devinatkin/tt07-dual-oscillator/(commit log)

2024-04-30 lab 1.2 - inverter schematic
    [top.sch]
2024-05-01 lab 2.2 completed
    [inverter.sch, inverter_tb.sch, untitled.sch]
2024-05-01 Lab 3.2 Start
    [top.sch]
2024-05-02 lab 3.2 complete
    [oscillator_20MHZ.sch, oscillator_21MHZ.sch, top.sch, top_tb.sch, untitled.sch]
2024-05-09 Setting Oscillators to roughly 20Mhz and 21Mhz
    [inverter.sch, oscillator_20MHZ.sch, oscillator_20MHZ_TB.sch, oscillator_21MHZ.sch, oscillator_21MHZ_TB.sch, top.sch, top_tb.sch, untitled.sch]
2024-05-23 Op Amp Schematic Completed
    [opamp_1.sch, opamp_1_tb.sch]
2024-05-23 Op Amp Layout V1 Complete
    [active-resistor.sch, activeload.sch, current_source.sch, current_source_tb.sch, indiff.sch, opamp_1.sch, opamp_1_tb.sch, opamp_1_tb_2.sch]
2024-05-24 Top Cell (passing LVS)
    [current_source.sch]
2024-05-28 Increase Post Layout Frequency
    [filter_oscillator_20mhz.sch, oscillator_20MHZ.sch, oscillator_20MHZ_TB.sch, oscillator_21MHZ.sch, oscillator_21MHZ_TB.sch, ps_oscillator_20mhz.sch, top_tb.sch, untitled-1.sch]
2024-05-29 Initial Filter Based Design
    [analog_buffer.sch, filter22M.sch, filter22M_TB.sch, single_transistor_filter_tb.sch, top.sch, top_tb.sch, top_tb_postL.sch, untitled-2.sch]
2024-05-31 Complete Full Layout (Passing All Checks)
    [capacitor_array.sch, filter22M.sch, top.sch]
2025-06-09 Add Scope Measurements
    [13mhz.csv, 14mhz.csv]
